FEASTorg/can-nano-shield-fieldbus/docs/index.md

---
title: "CAN Nano Shield Fieldbus Documentation"
description: "Overview and entry page for CAN Nano Shield Fieldbus project documentation."
nav_exclude: true
---

Welcome to the CAN Nano Shield Fieldbus project documentation.

## Board Renders

<figure style="display:inline-block; text-align:center; margin:10px;">
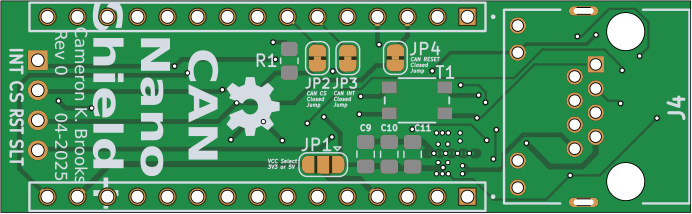
[picture p1: docs/assets/boards/board_top.png]
Board Top
  
  <figcaption>Top</figcaption>
</figure>

<figure style="display:inline-block; text-align:center; margin:10px;">
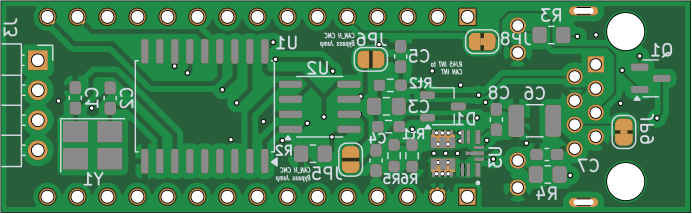
[picture p2: docs/assets/boards/board_bottom.png]
Board Bottom
  
  <figcaption>Bottom</figcaption>
</figure>
