FEASTorg/can-nano-shield-fieldbus/docs/kibot/index.md

---
title: "KiBot Outputs"
description: "Index for KiBot-generated PCB artifacts."
layout: "page"
---

These are the docs & KiBot Outputs for CAN Nano Shield Fieldbus

The following files were generated from the latest PCB build:

- [Schematic.pdf](./Schematic.pdf)
- [PCB.pdf](./PCB.pdf)
- [kibot.log](./kibot.log)
- [can-nano-shield-fieldbus-bom.html](./can-nano-shield-fieldbus-bom.html)
- [can-nano-shield-fieldbus-ibom.html](./can-nano-shield-fieldbus-ibom.html)

_Last updated automatically on 2026-06-13 at 02:05:13 UTC by KiBot via GitHub Actions._
