FEASTorg/can-nano-shield-fieldbus/docs/assets/images/board_bottom.png

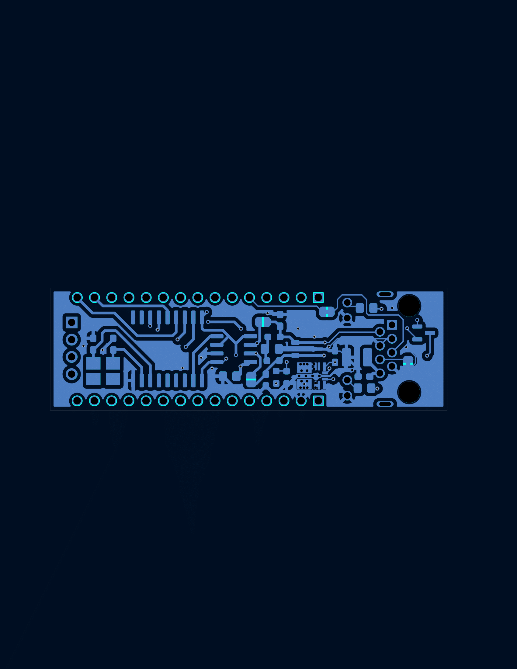
docs/assets/images/board_bottom.png
