FEASTorg/can-nano-shield-fieldbus/docs/assets/images/board_in2.png

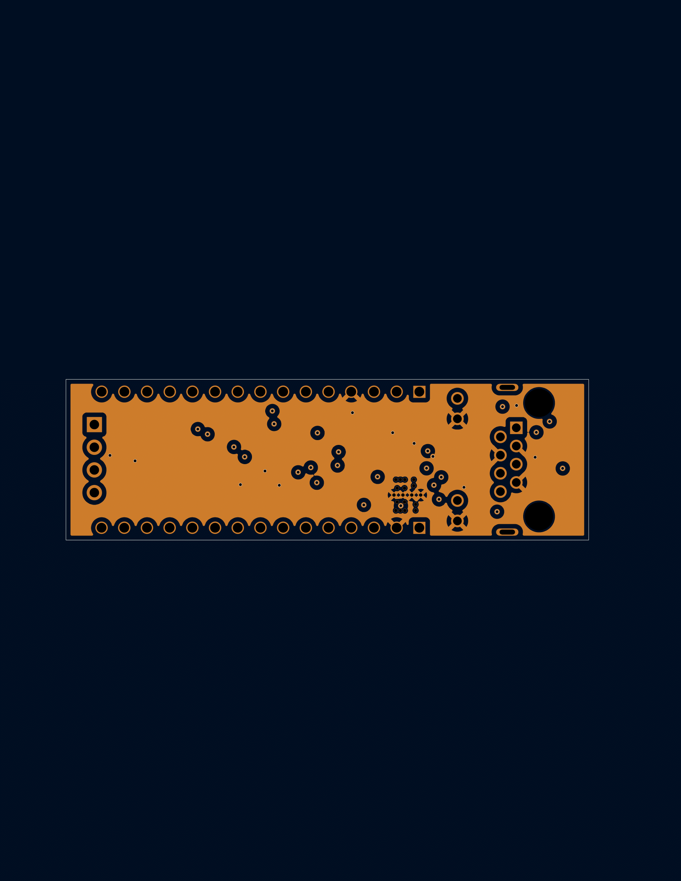
docs/assets/images/board_in2.png
