FEASTorg/can-nano-shield-fieldbus/docs/assets/images/board_top.png

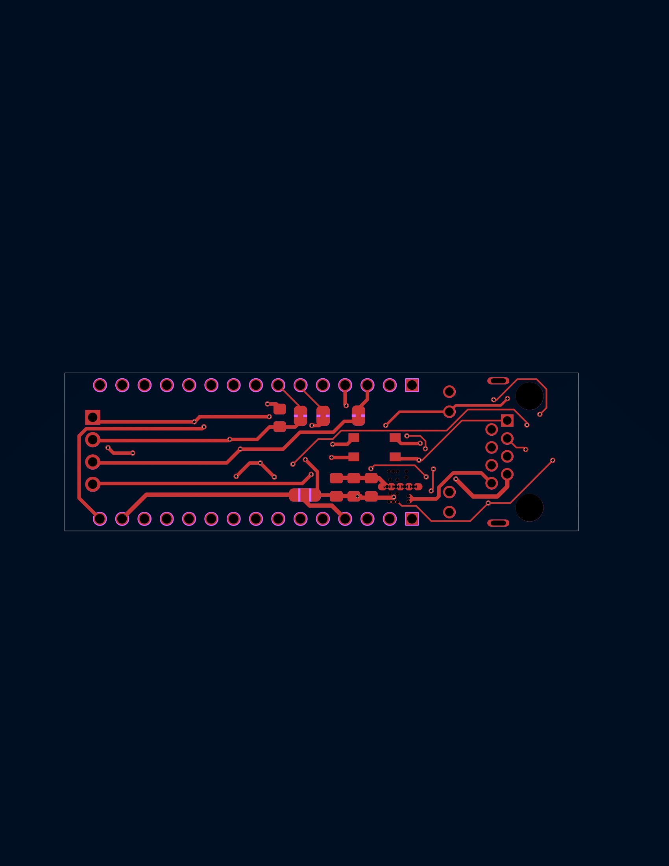
docs/assets/images/board_top.png
