FEASTorg/can-nano-shield-fieldbus/docs/assets/images/cmc_revision.jpg

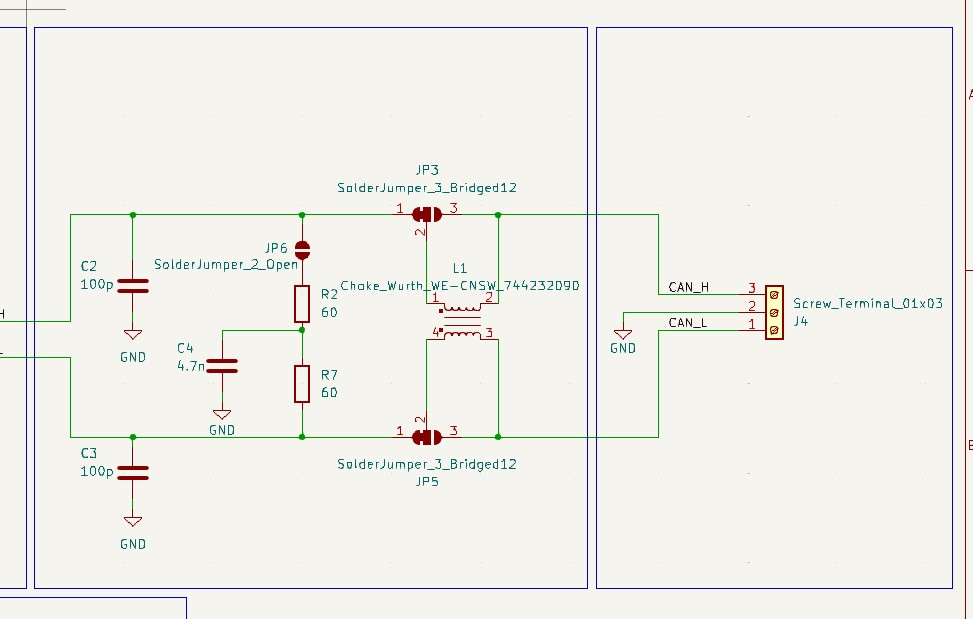
docs/assets/images/cmc_revision.jpg
