FEASTorg/can-nano-shield-fieldbus/docs/assets/images/schem-1.png

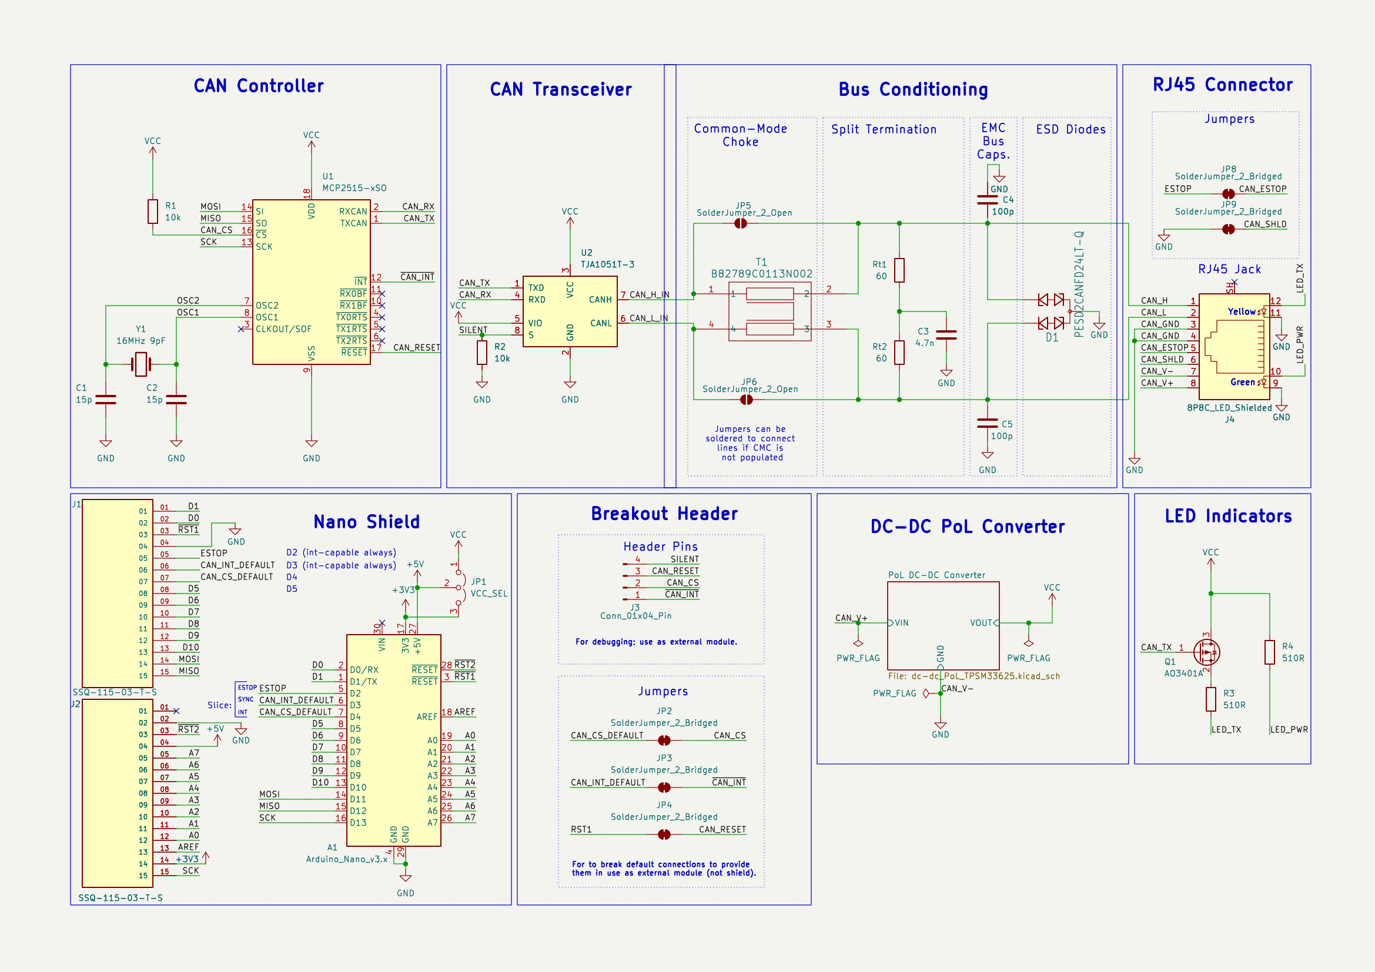
docs/assets/images/schem-1.png
