FEASTorg/can-nano-shield-fieldbus/docs/assets/images/schem-2.png

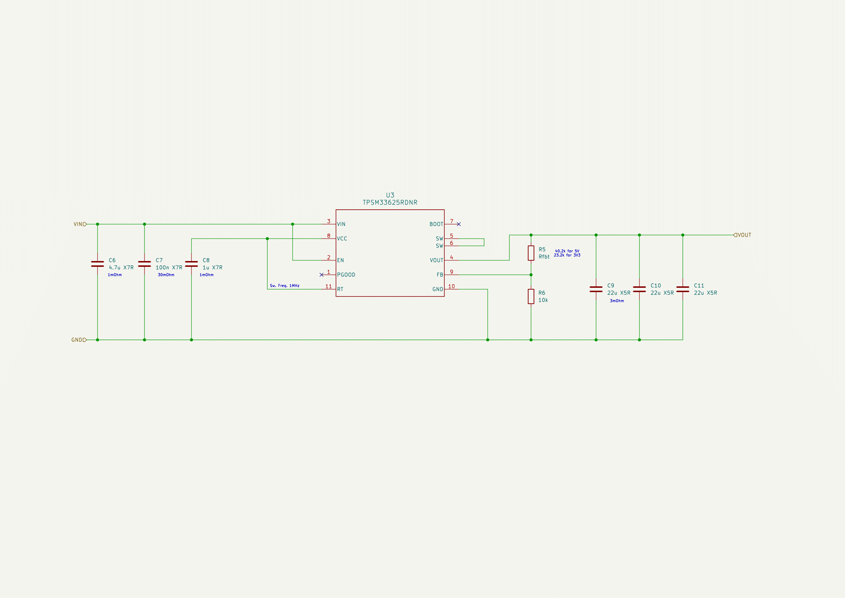
docs/assets/images/schem-2.png
