FEASTorg/can-nano-shield-fieldbus/docs/components-list.md

# Components List

- https://www.mouser.ca/ProductDetail/Nexperia/PESD2CANFD24LT-QR?qs=vvQtp7zwQdPkdQ8USTElVw%3D%3D

- https://www.mouser.ca/ProductDetail/Diodes-Incorporated/FL1600043?qs=ZrPdAQfJ6DNqHS0WyLoLKg%3D%3D

- CMC part: https://www.digikey.ca/en/products/detail/epcos-tdk-electronics/B82789C0113N002/2651641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

- 15 pin headers: https://www.digikey.ca/en/products/detail/samtec-inc/SSQ-115-03-T-S/1111943 ; https://www.samtec.com/products/ssq-115-03-t-s
