FEASTorg/can-nano-shield-fieldbus/hardware/can-nano-shield-fieldbus.kicad_pcb

## KiCad design hardware/can-nano-shield-fieldbus.kicad_pcb (2025-09-14)

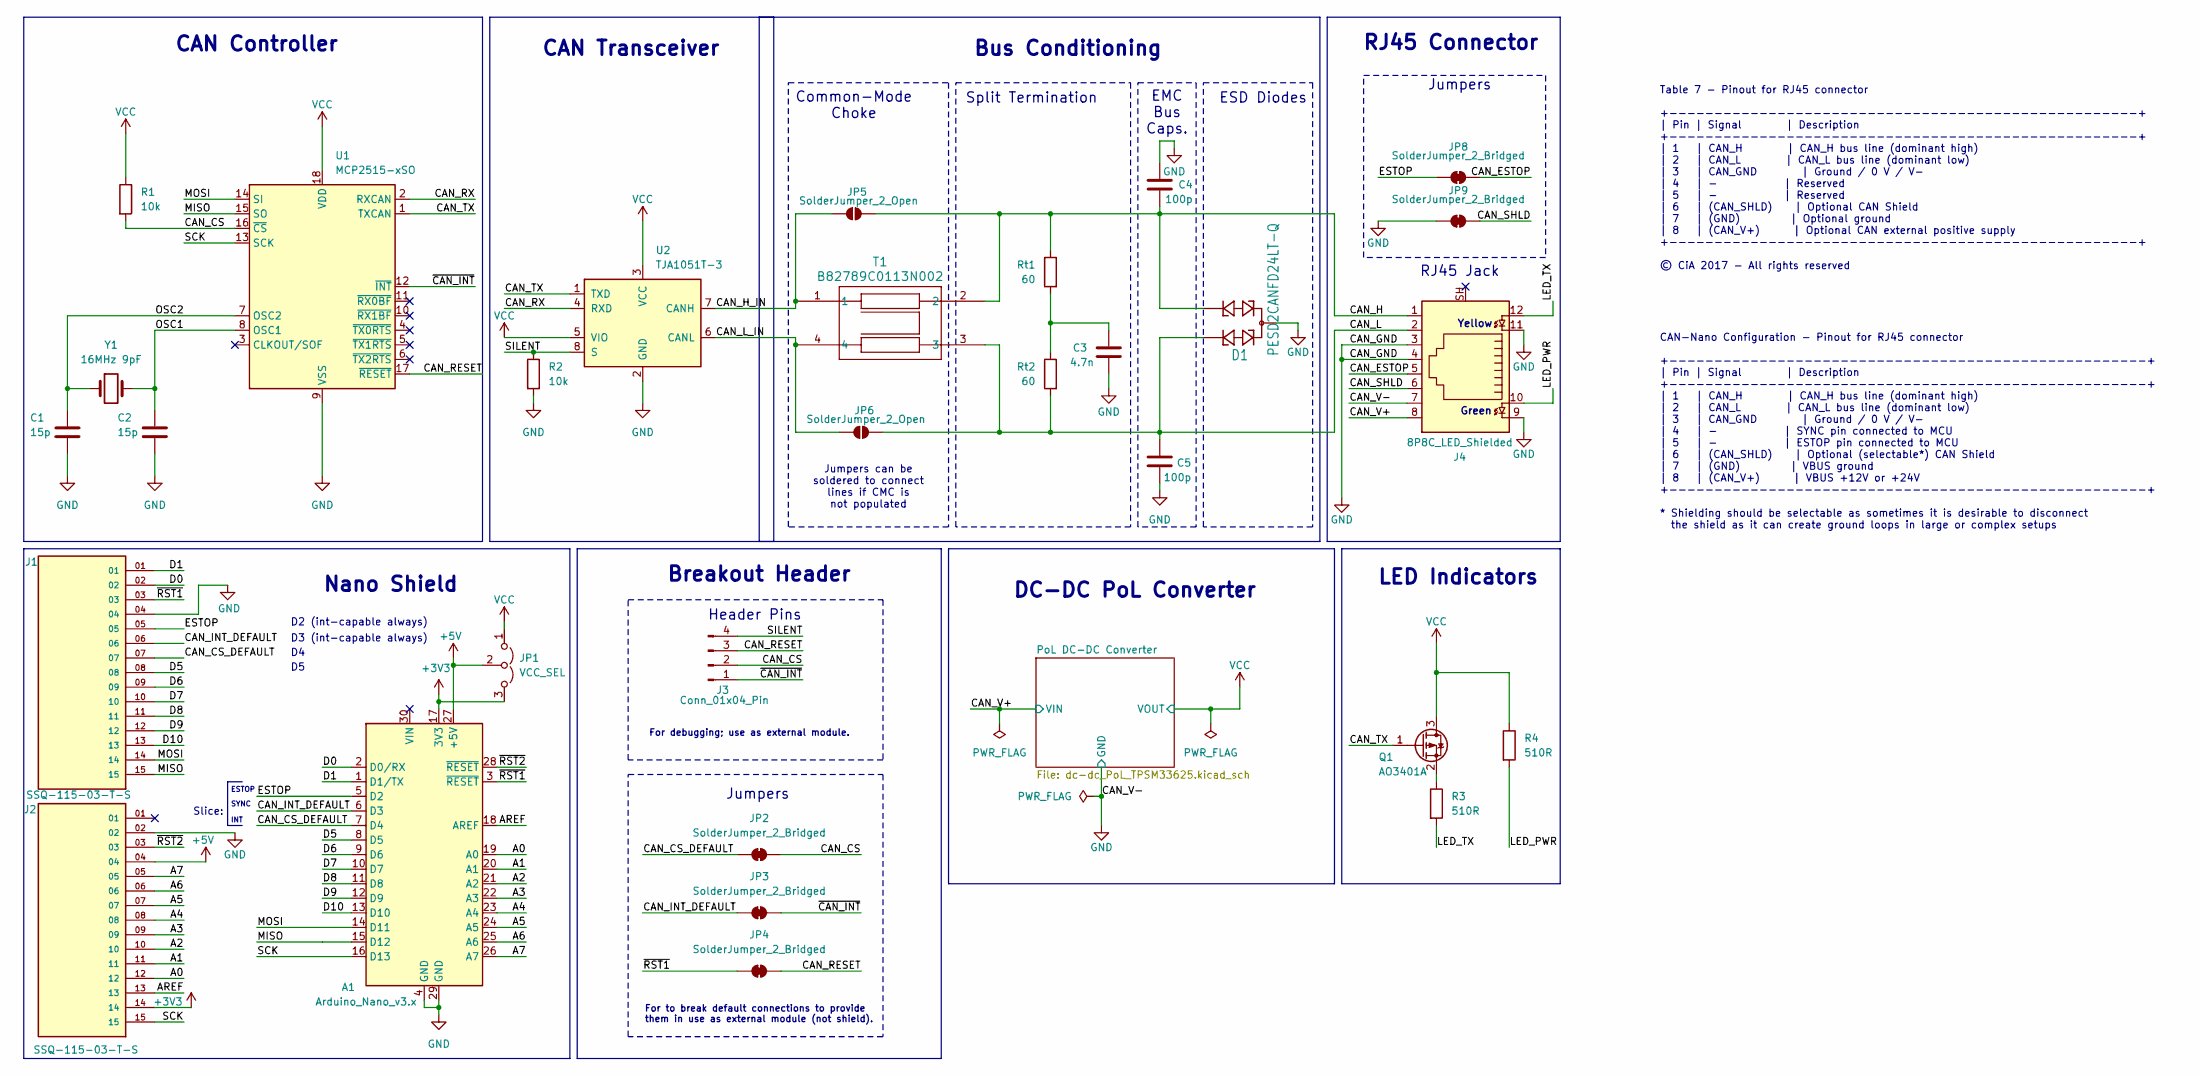
[picture p9: schematic can-nano-shield-fieldbus.kicad_sch]

Parts:
A1: Arduino_Nano_v3.x; Arduino_Nano
C1, C2: 15p; C_0603_1608Metric_Pad1.08x0.95mm_HandSolder
C3: 4.7n; C_0805_2012Metric_Pad1.18x1.45mm_HandSolder
C4, C5: 100p; C_0603_1608Metric_Pad1.08x0.95mm_HandSolder
D1: PESD2CANFD24LT-Q; TSOT-23
J1, J2: SSQ-115-03-T-S; SAMTEC_SSQ-115-03-T-S; PARTREV R
J3: Conn_01x04_Pin; PinHeader_1x04_P2.54mm_Horizontal
J4: 8P8C_LED_Shielded; 25015504-RJ45
JP1: VCC_SEL; SolderJumper-3_P1.3mm_Open_RoundedPad1.0x1.5mm
JP2, JP3, JP4, JP8, JP9: SolderJumper_2_Bridged; SolderJumper-2_P1.3mm_Bridged_RoundedPad1.0x1.5mm
JP5, JP6: SolderJumper_2_Open; SolderJumper-2_P1.3mm_Open_RoundedPad1.0x1.5mm
Q1: AO3401A; SOT-23
R1, R2: 10k; R_0805_2012Metric_Pad1.20x1.40mm_HandSolder
R3, R4: 510R; R_0805_2012Metric_Pad1.20x1.40mm_HandSolder
Rt1, Rt2: 60; R_0603_1608Metric_Pad0.98x0.95mm_HandSolder
T1: B82789C0113N002; SMT_13N002_TDK
U1: MCP2515-xSO; SOIC-18W_7.5x11.6mm_P1.27mm
U2: TJA1051T-3; SOIC-8_3.9x4.9mm_P1.27mm
Y1: 16MHz 9pF; Crystal_SMD_3225-4Pin_3.2x2.5mm_HandSoldering

Connections:
+3V3: A1.17 (3V3), J2.14, JP1.3 (B)
+5V: A1.27 (+5V), J2.04, JP1.2 (C)
/A0: A1.19 (A0), J2.12
/A1: A1.20 (A1), J2.11
/A2: A1.21 (A2), J2.10
/A3: A1.22 (A3), J2.09
/A4: A1.23 (A4), J2.08
/A5: A1.24 (A5), J2.07
/A6: A1.25 (A6), J2.06
/A7: A1.26 (A7), J2.05
/AREF: A1.18 (AREF), J2.13
/CAN_CS: J3.2, JP2.2 (B), R1.2, U1.16 (~CS)
/CAN_CS_DEFAULT: A1.7 (D4), J1.07, JP2.1 (A)
/CAN_ESTOP: J4.5, JP8.2 (B)
/CAN_H: C4.2, D1.1, J4.1, JP5.2 (B), Rt1.1, T1.2
/CAN_H_IN: JP5.1 (A), T1.1, U2.7 (CANH)
/CAN_INT_DEFAULT: A1.6 (D3), J1.06, JP3.1 (A)
/CAN_L: C5.1, D1.2, J4.2, JP6.2 (B), Rt2.2, T1.3
/CAN_L_IN: JP6.1 (A), T1.4, U2.6 (CANL)
/CAN_RESET: J3.3, JP4.2 (B), U1.17 (~RESET)
/CAN_RX: U1.2 (RXCAN), U2.4 (RXD)
/CAN_SHLD: J4.6, JP9.2 (B)
/CAN_TX: Q1.1 (G), U1.1 (TXCAN), U2.1 (TXD)
/CAN_V+: J4.8; also elsewhere on the board
/D0: A1.2 (D0/RX), J1.02
/D1: A1.1 (D1/TX), J1.01
/D5: A1.8 (D5), J1.08
/D6: A1.9 (D6), J1.09
/D7: A1.10 (D7), J1.10
/D8: A1.11 (D8), J1.11
/D9: A1.12 (D9), J1.12
/D10: A1.13 (D10), J1.13
/ESTOP: A1.5 (D2), J1.05, JP8.1 (A)
/LED_PWR: J4.10, R4.2
/LED_TX: J4.12, R3.2
/MISO: A1.15 (D12), J1.15, U1.15 (SO)
/MOSI: A1.14 (D11), J1.14, U1.14 (SI)
/OSC1: C2.1, U1.8 (OSC1), Y1.2
/OSC2: C1.1, U1.7 (OSC2), Y1.1
/RST1: A1.3 (~RESET), J1.03, JP4.1 (A)
/RST2: A1.28 (~RESET), J2.03
/SCK: A1.16 (D13), J2.15, U1.13 (SCK)
/SILENT: J3.4, R2.1, U2.8 (S)
/~CAN_INT: J3.1, JP3.2 (B), U1.12 (~INT)
GND: A1.4 (GND), A1.29 (GND), C1.2, C2.2, C3.2, C4.1, C5.2, D1.3, J1.04, J2.02, J4.3, J4.4, J4.7, J4.9, J4.11, JP9.1 (A), R2.2, U1.9 (VSS), U2.2 (GND); also elsewhere on the board
unnamed: C3.1, Rt1.2, Rt2.1
unnamed: Q1.2 (S), R3.1
VCC: JP1.1 (A), Q1.3 (D), R1.1, R4.1, U1.18 (VDD), U2.3 (VCC), U2.5 (VIO); also elsewhere on the board

Notes on the sheet:
Header Pins
EMC Bus Caps.
ESTOP
For debugging; use as external module.
Slice:
RJ45 Jack
Bus Conditioning
Breakout Header
INT
Jumpers
CAN Controller
ESD Diodes
For to break default connections to provide them in use as external module (not shield).
D3 (int-capable always)
Split Termination
SYNC
CAN Transceiver
RJ45 Connector
LED Indicators
CAN-Nano Configuration - Pinout for RJ45 connector +-----------------------------------------------------+ | Pin | Signal | Description +-----------------------------------------------------+ | 1 | CAN_H | CAN_H bus line (dominant high) | 2 | CAN_L | CAN_L bus line (dominant low) | 3 | CAN_GND | Gr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
Yellow
D2 (int-capable always)
DC-DC PoL Converter
Jumpers can be soldered to connect lines if CMC is not populated
Common-Mode Choke
Table 7 - Pinout for RJ45 connector +----------------------------------------------------+ | Pin | Signal | Description +----------------------------------------------------+ | 1 | CAN_H | CAN_H bus line (dominant high) | 2 | CAN_L | CAN_L bus line (dominant low) | 3 | CAN_GND | Ground / 0 V / V- |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
Nano Shield
Green

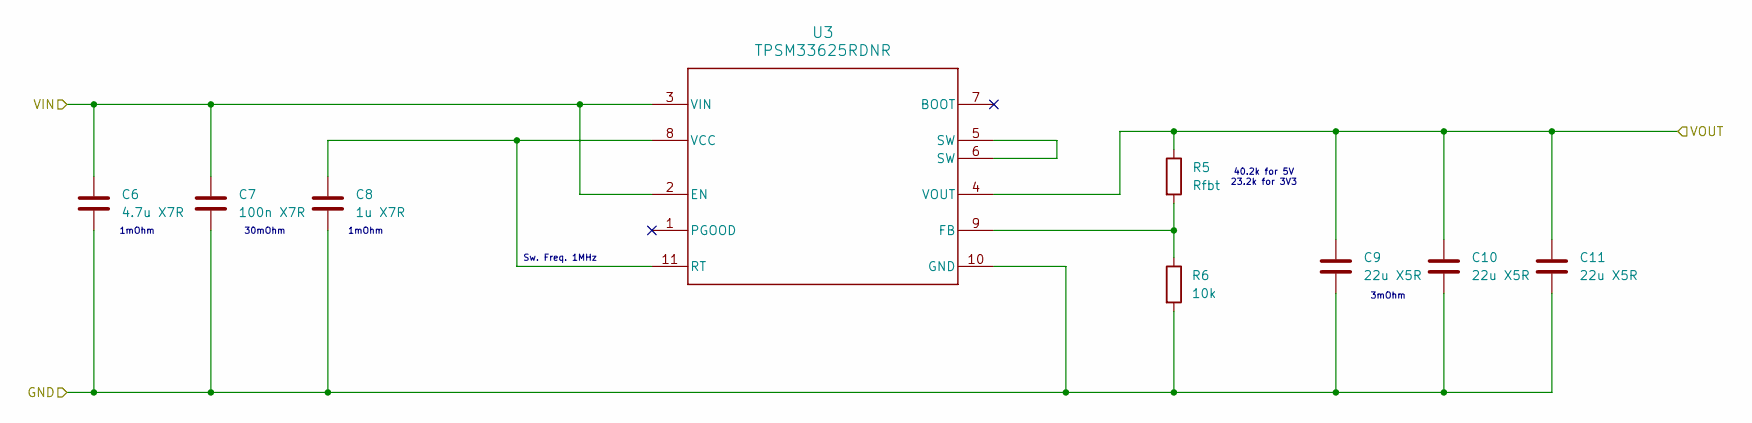
[picture p10: schematic dc-dc_PoL_TPSM33625.kicad_sch]

Parts:
C6: 4.7u X7R; C_1210_3225Metric_Pad1.33x2.70mm_HandSolder
C7: 100n X7R; C_0603_1608Metric_Pad1.08x0.95mm_HandSolder
C8: 1u X7R; C_0603_1608Metric_Pad1.08x0.95mm_HandSolder
C9, C10, C11: 22u X5R; C_0805_2012Metric_Pad1.18x1.45mm_HandSolder
R5: Rfbt; R_0603_1608Metric_Pad0.98x0.95mm_HandSolder
R6: 10k; R_0603_1608Metric_Pad0.98x0.95mm_HandSolder
U3: TPSM33625RDNR; CONV_TLVM23615RDNR

Connections:
/CAN_V+: C6.1, C7.1, U3.2 (EN), U3.3 (VIN), U3.3_1, U3.3_2; also elsewhere on the board
GND: C6.2, C7.2, C8.2, C9.2, C10.2, C11.2, R6.2, U3.10 (GND), U3.10_2, U3.10_3, U3.10_4, U3.10_5; also elsewhere on the board
unnamed: R5.2, R6.1, U3.9 (FB)
unnamed: C8.1, U3.8 (VCC), U3.11 (RT)
unnamed: U3.5 (SW), U3.5_1, U3.5_2, U3.5_3, U3.5_4, U3.5_5, U3.6 (SW), U3.6_1, U3.6_2
VCC: C9.1, C10.1, C11.1, R5.1, U3.4 (VOUT), U3.4_1, U3.4_2, U3.4_3, U3.4_4, U3.4_5; also elsewhere on the board

Notes on the sheet:
Sw. Freq. 1MHz
30mOhm
1mOhm
3mOhm
40.2k for 5V 23.2k for 3V3

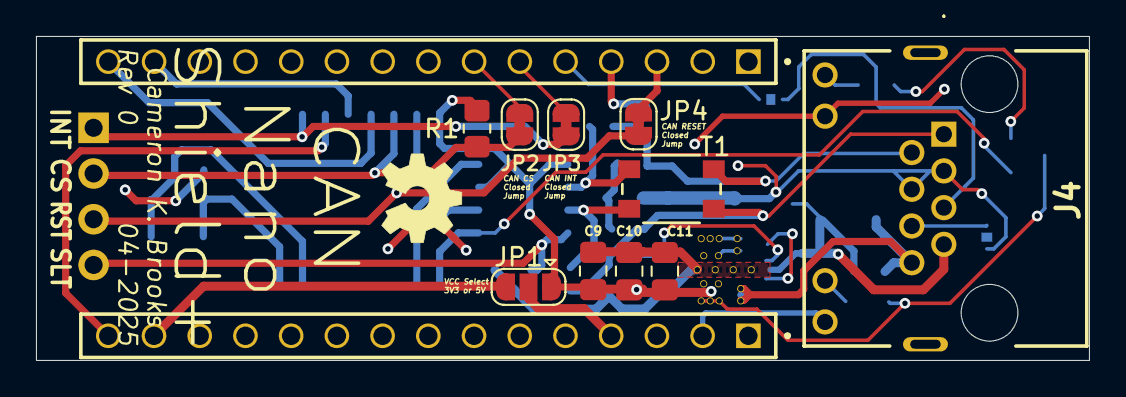
[picture p11: board can-nano-shield-fieldbus.kicad_pcb from above]

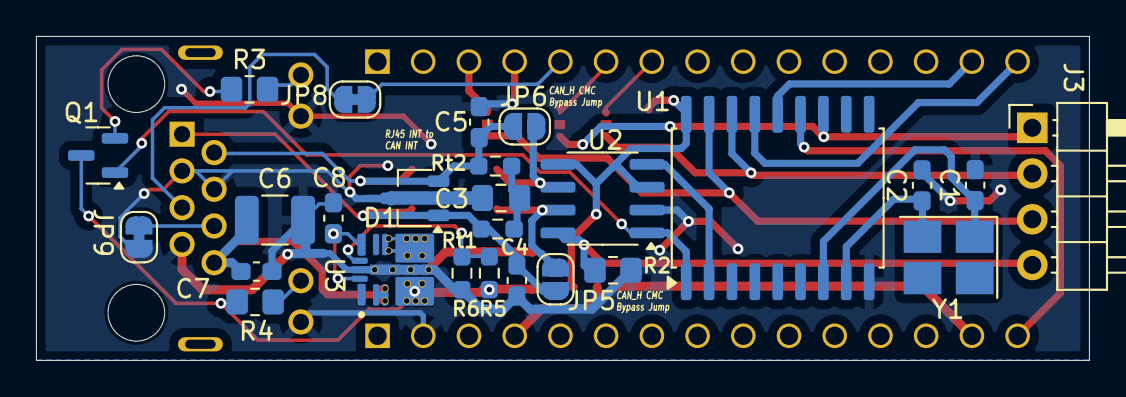
[picture p12: board can-nano-shield-fieldbus.kicad_pcb from below]

Board: 4 copper layers, 58.5 x 18.0 mm, 39 parts (26 on the bottom side), 33 nets.

Other parts of the board:
Ref**: Val**; OSHW_Logo_5mm
