FEASTorg/can-nano-shield-fieldbus/(commit log)

2025-04-01 added image with cmc revision
    [can-nano-shield.kicad_sch]
2025-04-02 updated with cmc inductor + esd diode + emc caps on H L inputs
    [can-nano-shield.kicad_pcb, can-nano-shield.kicad_sch]
2025-04-22 added outputs
    [can-nano-shield-B_Cu.gbr, can-nano-shield-B_Mask.gbr, can-nano-shield-B_Paste.gbr, can-nano-shield-B_Silkscreen.gbr, can-nano-shield-Edge_Cuts.gbr, can-nano-shield-F_Cu.gbr, can-nano-shield-F_Mask.gbr, can-nano-shield-F_Paste.gbr]
2025-04-22 updated parts dump
    [can-nano-shield_procurement.ods]
2025-04-25 fixed schem and corresponding hw
    [can-nano-shield-rj45-B_Cu.gbr, can-nano-shield-rj45-B_Mask.gbr, can-nano-shield-rj45-B_Paste.gbr, can-nano-shield-rj45-B_Silkscreen.gbr, can-nano-shield-rj45-Edge_Cuts.gbr, can-nano-shield-rj45-F_Cu.gbr, can-nano-shield-rj45-F_Mask.gbr, can-nano-shield-rj45-F_Paste.gbr]
2025-04-25 update ouputs
    [can-nano-shield-rj45-B_Cu.gbr, can-nano-shield-rj45-B_Mask.gbr, can-nano-shield-rj45-B_Paste.gbr, can-nano-shield-rj45-B_Silkscreen.gbr, can-nano-shield-rj45-Edge_Cuts.gbr, can-nano-shield-rj45-F_Cu.gbr, can-nano-shield-rj45-F_Mask.gbr, can-nano-shield-rj45-F_Paste.gbr]
2025-09-14 minor: minor update before split of rj45
    [can-nano-shield-rj45.kicad_pcb, can-nano-shield-rj45.kicad_sch]
2025-09-14 initial commit of split
    [can-nano-shield-B_Cu.gbr, can-nano-shield-B_Mask.gbr, can-nano-shield-B_Paste.gbr, can-nano-shield-B_Silkscreen.gbr, can-nano-shield-Edge_Cuts.gbr, can-nano-shield-F_Cu.gbr, can-nano-shield-F_Mask.gbr, can-nano-shield-F_Paste.gbr]
2025-09-14 docs: initial commit of docs using slice-infra
    [can-nano-shield-rj45.kicad_pcb, can-nano-shield-rj45.kicad_sch]
2025-09-14 hardware: fix naming for consistency and reoutput
    [can-nano-shield-fieldbus-B_Adhesive.gbr, can-nano-shield-fieldbus-B_Cu.gbr, can-nano-shield-fieldbus-B_Mask.gbr, can-nano-shield-fieldbus-B_Paste.gbr, can-nano-shield-fieldbus-B_Silkscreen.gbr, can-nano-shield-fieldbus-Edge_Cuts.gbr, can-nano-shield-fieldbus-F_Adhesive.gbr, can-nano-shield-fieldbus-F_Cu.gbr]
2025-09-14 📄 KiBot index + board renders (auto)
2025-09-14 docs(ci): remove usage of inner copper layer images as pcb draw doesnt support
2025-09-23 enh: add inner layers to pcb pdf output from kibot
