FEASTorg/can-nano-shield-fieldbus/(notices)

Notices in the files:
hardware/can-nano-shield-fieldbus.kicad_sch:
© CiA 2017 - All rights reserved
